mrred2k/reflowOvenController/hardware/ReflowController_true_rev2.brd.preview.png

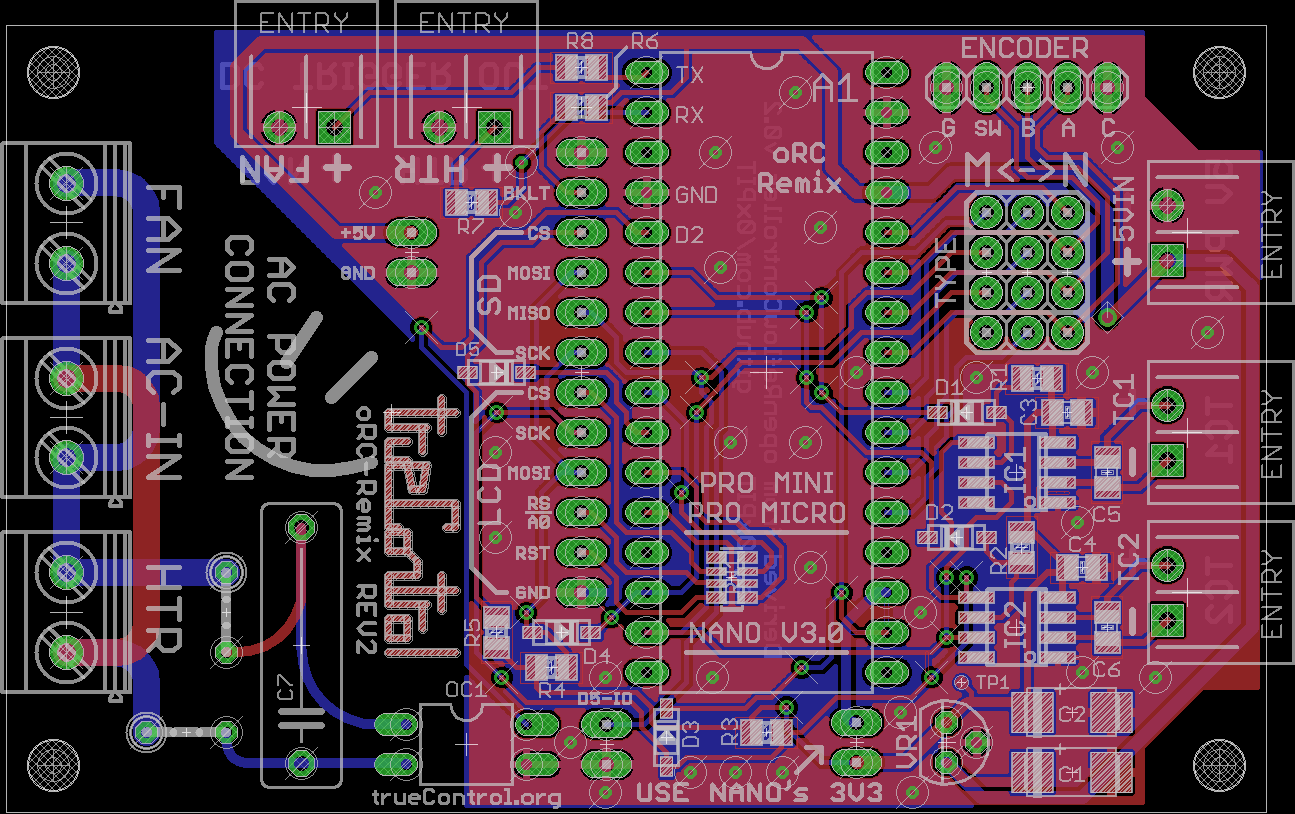
hardware/ReflowController_true_rev2.brd.preview.png
