mrred2k/reflowOvenController/hardware/ReflowController_true_rev2.sch.preview.png

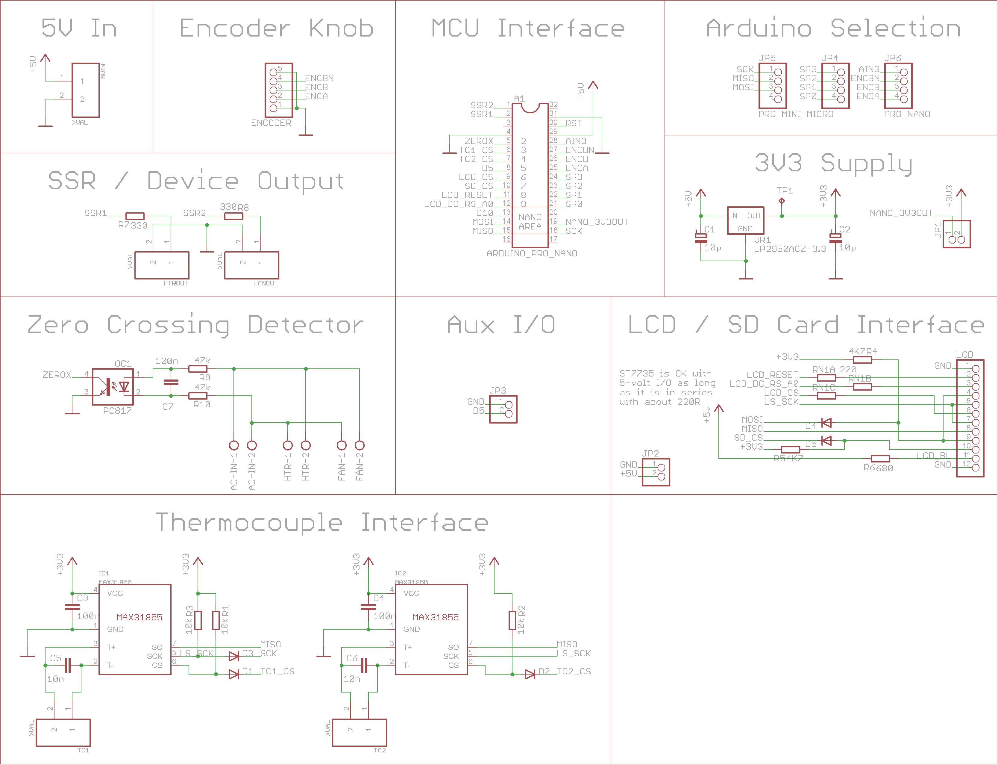
hardware/ReflowController_true_rev2.sch.preview.png
