mrred2k/reflowOvenController/hardware/ReflowController_true_rev2.brd

## EAGLE design hardware/ReflowController_true_rev2.brd (2015-01-13)

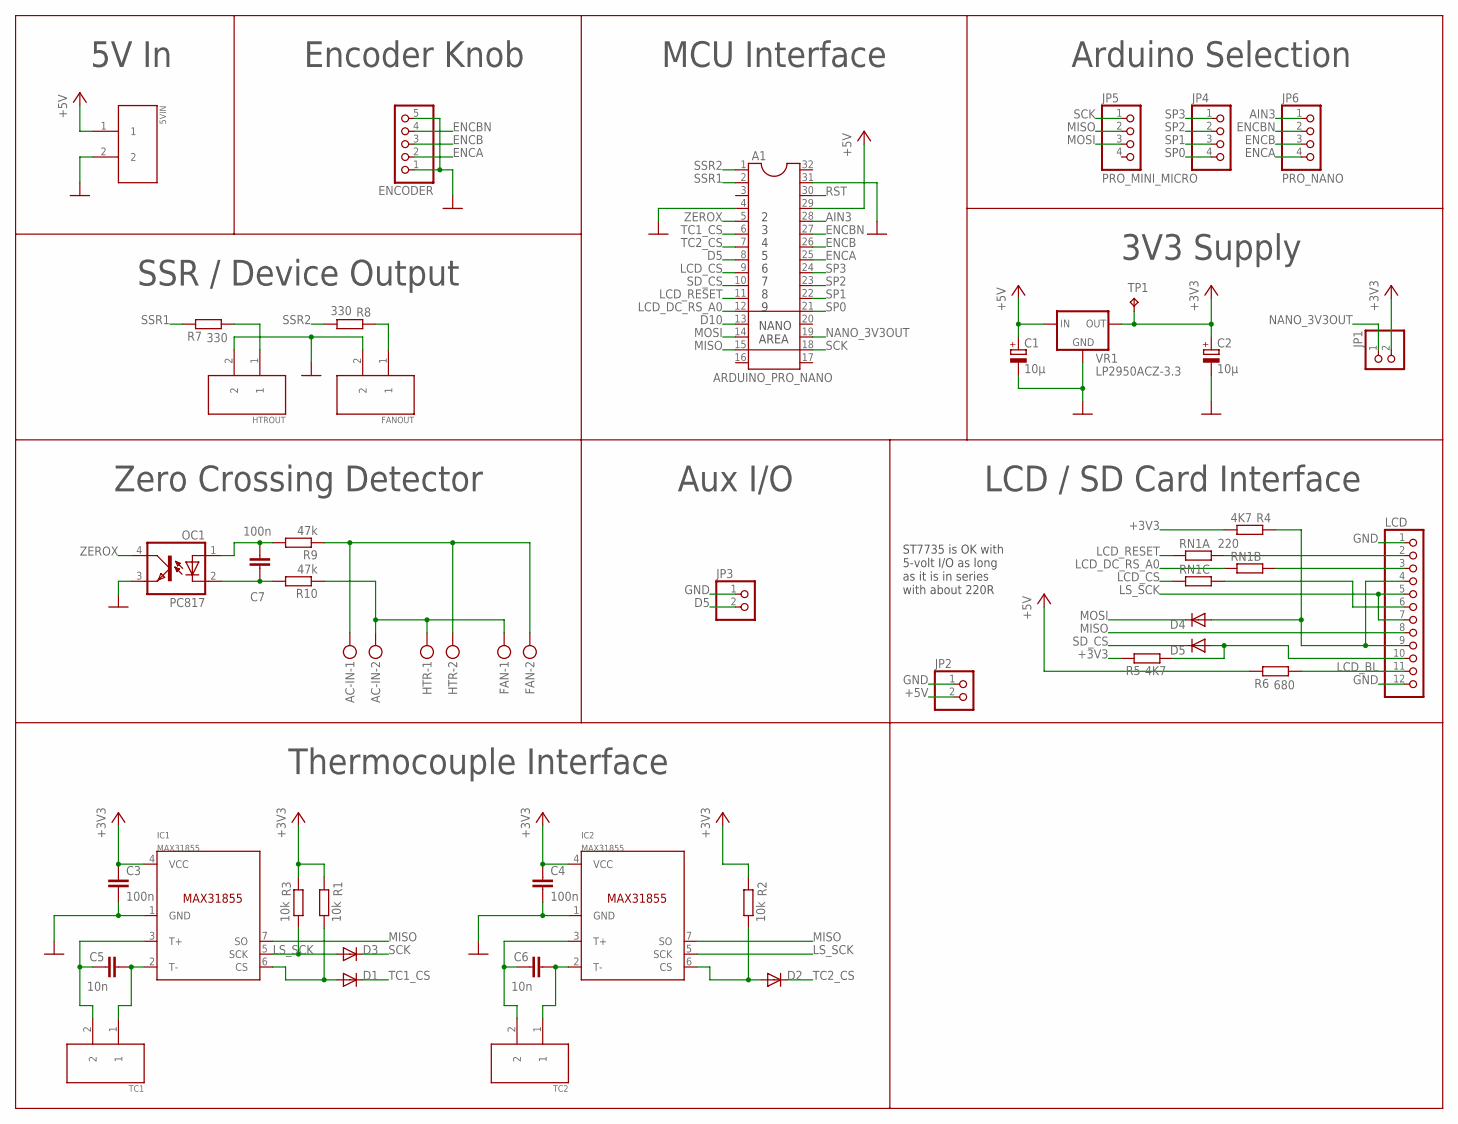
[picture p17: schematic ReflowController_true_rev2.sch]

Parts:
5VIN: WECO_110-M-221/2; WECO-PHOENIXTERM-2-POS
A1: ARDUINO_PRO_NANO; DIL32
AC-IN: MKDSN1,5/2-5,08
C1, C2: 10µ; C/6032-28R
C3, C4: 100n; C0805
C5, C6: 10n; C0805
C7: 100n; C150-054X183
D1, D2, D3, D4, D5: DIODESOD-123; SOD-123
ENCODER: PINHD-1X5; 1X05
FAN: MKDSN1,5/2-5,08
FANOUT: WECO_110-M-221/2; WECO-PHOENIXTERM-2-POS
HTR: MKDSN1,5/2-5,08
HTROUT: WECO_110-M-221/2; WECO-PHOENIXTERM-2-POS
IC1, IC2: MAX31855; SOIC8
JP1, JP2, JP3: PINHD-1X2; 1X02
JP4: PINHD-1X4RND; 1X04_RND
JP5: PRO_MINI_MICRO; 1X04_RND
JP6: PRO_NANO; 1X04_RND
LCD: PINHD-1X12; 1X12
OC1: PC817; DIL04
R1, R2, R3: 10k; R0805
R4, R5: 4K7; R0805
R6: 680; R0805
R7, R8: 330; R0805
R9, R10: 47k; 0207/5V
RN1: 220; RN8P-4R-CRA06S
TC1, TC2: WECO_110-M-221/2; WECO-PHOENIXTERM-2-POS
TP1: TPTP08R; TP08R
VR1: LP2950ACZ-3.3; TO92

Connections:
+3V3: C2.+, C3.1, C4.1, IC1.4 (VCC), IC2.4 (VCC), JP1.2, R1.2, R2.2, R3.2, R4.1, R5.2, TP1.TP, VR1.1 (OUT)
+5V: 5VIN.1, A1.29, C1.+, JP2.2, R6.2, VR1.3 (IN)
AC1: AC-IN.1, FAN.2, HTR.2, R9.1
AC2: AC-IN.2, FAN.1, HTR.1, R10.1
AIN3: A1.28, JP6.1
D5: A1.8, JP3.2
D10: A1.13
ENCA: A1.25, ENCODER.2, JP6.4
ENCB: A1.26, ENCODER.3, JP6.3
ENCBN: A1.27, ENCODER.4, JP6.2
GND: 5VIN.2, A1.4, A1.31, C1.-, C2.-, C3.2, C4.2, ENCODER.1, ENCODER.5, FANOUT.2, HTROUT.2, IC1.1 (GND), IC2.1 (GND), JP2.1, JP3.1, LCD.1, LCD.12, OC1.3 (EMIT), VR1.2 (GND)
LCD_BL: LCD.11, R6.1
LCD_CS: A1.9, RN1.3 (1)
LCD_DC_RS_A0: A1.12, RN1.2 (1)
LCD_RESET: A1.11, RN1.1
LS_MOSI: D4.A, LCD.4, LCD.9, R4.2
LS_SCK: D3.A, IC1.5 (SCK), IC2.5 (SCK), LCD.5, LCD.7, R3.1
LS_SD_CS: D5.A, LCD.10, R5.1
MISO: A1.15, IC1.7 (SO), IC2.7 (SO), JP5.2, LCD.8
MOSI: A1.14, D4.C, JP5.3
unnamed: C5.2, IC1.2 (T-), TC1.1
unnamed: C6.2, IC2.2 (T-), TC2.1
unnamed: C6.1, IC2.3 (T+), TC2.2
unnamed: LCD.3, RN1.7 (2)
unnamed: LCD.6, RN1.6 (2)
unnamed: C7.2, OC1.1 (A), R9.2
unnamed: LCD.2, RN1.8 (2)
unnamed: C7.1, OC1.2 (C), R10.2
unnamed: C5.1, IC1.3 (T+), TC1.2
unnamed: D2.A, IC2.6 (CS), R2.1
unnamed: D1.A, IC1.6 (CS), R1.1
NANO_3V3OUT: A1.19, JP1.1
RST: A1.30
SCK: A1.18, D3.C, JP5.1
SD_CS: A1.10, D5.C
SP0: A1.21, JP4.4
SP1: A1.22, JP4.3
SP2: A1.23, JP4.2
SP3: A1.24, JP4.1
SSR1: A1.2, R7.2
SSR1OUT: HTROUT.1, R7.1
SSR2: A1.1, R8.1
SSR2_OUT: FANOUT.1, R8.2
TC1_CS: A1.6, D1.C
TC2_CS: A1.7, D2.C
ZEROX: A1.5, OC1.4 (COL)

Notes on the sheet:
NANO AREA
MCU Interface
Arduino Selection
3V3 Supply
5V In
Encoder Knob
LCD / SD Card Interface
SSR / Device Output
Zero Crossing Detector
Aux I/O
Thermocouple Interface
ST7735 is OK with 5-volt I/O as long as it is in series with about 220R

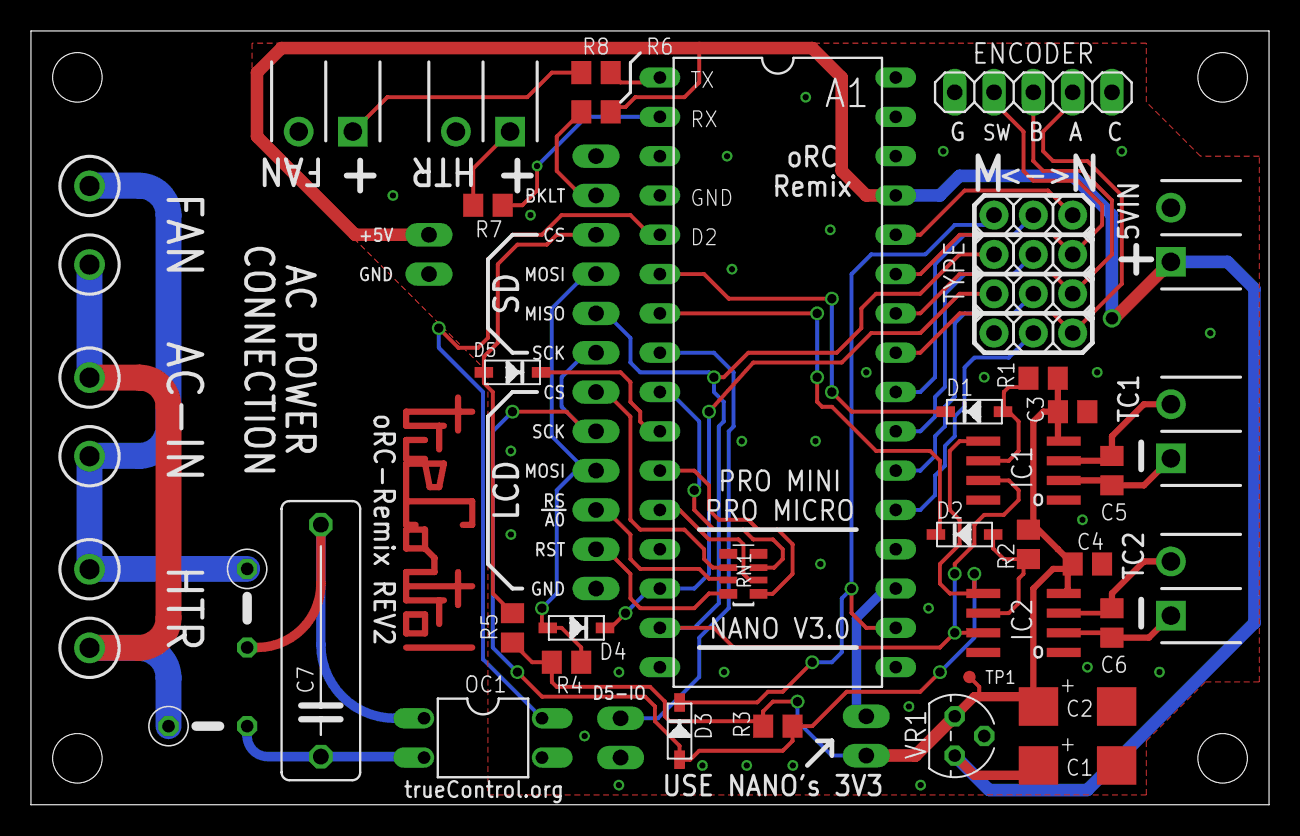
[picture p18: board ReflowController_true_rev2.brd from above]

Board: 2 copper layers, 80.0 x 50.0 mm, 46 parts (0 on the bottom side), 44 nets.

Other parts of the board:
U$1: TC_LOGO
