mrred2k/reflowOvenController/(commit log)

2015-01-13 merg true and kps versions
    -new HQ previews of all boards and schematics
    -tidy - filenames , pdf and documentation
    -new filenames for different variants
    [ReflowController_kp.v2.1.brd, ReflowController_kp.v2.1.sch, ReflowController_kp_bom.csv, ReflowController_true_rev2.brd, ReflowController_true_rev2.sch, bom.csv, bom_kp.csv, bom_true_rev2.csv]
2015-01-13 -bom fix
    [bom_true_rev2.csv]
2015-01-13 -fix bom
    [bom_true_rev2.csv]
2015-01-13 -fix bom csv...
    [bom_true_rev2.csv]
2015-04-23 Beeper added
    Adds some audio feedback for init (very short beep), error (long beep),
    start of cooldown phase (short beep) and end of reflow process (three
    beeps).
    Unfortunately, the sketch size gets too long for the Leonardo. Some
    other code has to be removed in order to successfully flash this.
    [ReflowController.ino]
2015-04-25 Fixed Beeper commit , can now be disables to save space
    Problem with TimerThree and Beeper fixed in this version. Used NewTone
    libary which is smaller and without compatibily issues with the timer
    libaries.
    [ReflowController.ino]
